Jamkly/planta-nivel-umsa/semestres/II 2023/3. Diseño de controladores/Caracterización de la planta/caracterizacion del sistema.docx

Universidad “Mayor de San Andrés”

FACULTAD DE INGENIERIA


CARACTERISTICAS DEL SISTEMA

Integrantes:

Univ. Espino Marca Mary Isabel

Univ. Condori Mamani Roger

Univ. Linares Poma Guido Alvaro

Univ. Huanaco Condori Heydi Marilyn

Univ. Quispe Lucana Williams

Univ. Ramos Queso Edith Elvira

Carrera: Ing. Electrónica

Materia: ETN-1034

Docente: Ing. Jorge Antonio Nava Amador

La Paz – Bolivia

# 1. MODELO ANALITICO

## 1.1 Linealizacion

Se tiene un tanque vertical abierto, provisto de un orificio o restriccion de descarga en su parte inferior, el tanque tiene un area A=l_1 xl_2 , tiene un caudal de entrada q_e por la parte superior , y un caudal q_s a la atmosfera por el orificio mencionado anteriormente.

donde:

A:area del tanque

q_e :caudal de entrada

q_s :caudal de salida

k:coeficiente de restriccion

h:altura del deposito


El caudal que fluye por una una restriccion sigue, basicamente, una ley cuadratica con la presion diferencial, pues se asume regimen turbulento.

En nuestro caso , un tanque abierto a la atmosfera, la presion diferencial en la restriccion de salida es debida a la presion hidrostatica existente como consecuencia del nivel de liquido en el tanque.

Si h es la altura del liquido, y k es un coeficiente dependiente de la geometria de la restriccion y de la densidad del liquido, el caudal de salida sera.

q_s =k√h (1)

Balance masico de caudales

entrada-salida=acumulacion

Por otra parte (dV)/(dt) es un caudal, y por otra parte dV=Adh , se tendria:

q_e -q_s =A(dh)/(dt) (2)

Es intuitivo el hecho de que, para un caudal de entrada constante, el nivel se estabilizara en un punto determinado, cuando la salida se iguale con la entrada, ya que a mayor nivel, mayor caudal de salida y viceversa.

Remplazando (2) en (1)

q_e -k√h=A(dh)/(dt) (3)

La ecuacion (3) es una funcion no lineal, entonces para linealizar se escoge un punto de equilibrio, es decir halla la altura de equilibrio h_0 , dado un determinado caudal de entrada q_e .

Entonces q_e =q_s y por tanto h=((q_s)/k)^2 . Pero el calculo se complica para condiciones transitorias , cuando q_s ≠q_e .

Es por ello, que en estos casos se procede linealizar la funcion de la ecuacion (3), mediante alguna forma de ecuacion aproximada, de tal manera que la ecuacion del caudal de salida q_s es sustituida por una ecuacion lineal.

Para ello se define una valor medio de h_m , preferentemente al nivel normal de trabajo, al que llamaremos nivel medio h_m y se opera con una funcion que corresponda a la ecuacion de una recta tangente a la funcion original en el punto [ h=h_m , q_s =q_m ].

Los valores medios, para el nivel medio normalmente el nivel de trabajo seran:

- Pendiente m de la recta tangente

m=(dq_s)/(dh)|_(h=h_m) =1/2k1/(√(h_m)) (4)

- Caudal medio de salida q_m :

q_m =k √(h_m) (5)

Por lo que:

k=(q_m)/(√(h_m)) (6) y, m=(q_m)/(2h_m) (7)

Efectuando un cambio de cordenadas a [ h_m , q_m ], en donde q y h representan los valores absolutos de las variables.


Con lo que la nueva ecuacion del balance masico queda:

q_e -mh=A(dh)/(dt) (8)

Reordenando y aplicando la transformada de laplace a la ecuacion (8)

Q_e =AsH+mH=H(As+m)

Entonces la función de transferencia será:

H/(Q_e)=1/(As+m)=(1/m)/((As)/m+1)=K/(Ts+1)

H/(Q_e)=K/(Ts+1) (9) funcion de transferencia linealizada


Donde:

q_m

h_m

K=1/m=Ganancia del sistema

T=A/m=Constante de tiempo

En el laboratorio se obtuvo las siguientes mediciones:

h_m =0.367m

q_m =0.28x10^(-3) (m^3)/s

Realizando calculos y remplazando en (9)

m=(q_m)/(2h_m)=(0.28x10^(-3))/(2⋅0.367)=0.381x10^(-3) (m^2)/s

H/(Q_e)=1/(As+m)=(1/m)/((As)/m+1)=2624.67/(419.95s+1)

H/(Q_e)=2624.67/(419.95s+1) funcion de transferencia analitica


Por otro lado realizando la linealizacion por series de taylor, tomando la siguiente ecuación no lineal:

A(dh)/(dT)=qe-k_2 a√(2gh)

Realizando la linealizacion se obtiene:

H/(Q_e)=1/(A S+(K_2 a √5)/(√(h_0)))

H/(Q_e)=1/(0.16 S+(0.02√5)/(√0.187))

H/(Q_e)=1/(0.16 S+(0.02√5)/(√0.187))

H/(Q_e)=1/(0.16 S+0.103)

Donde:

A=Area en m^2

h_0 =Altura donde el caudal de salida y entrada es igual,es decir no hay cambio en la altura

a=Areade la valvula de salida (del pequeño)

K_2 =Llave de paso que varia entre 0 y 1, tomando como 1 totalmente abierta

H=Altura de nivel

Q_e =Entrada de caudal


## 1.2 Modelo de la planta

Se tiene un tanque vertical abierto, provisto de un orificio o restricción de descarga en su parte inferior, el tanque tiene un área A=l_1 xl_2 , tiene un caudal de entrada q_e por la parte superior , y un caudal q_s a la atmosfera por el orificio mencionado anteriormente.


Donde:

A=l_1 xl_2 : área del tanque

q_e : caudal de entrada

q_s : caudal de salida

k: coeficiente de restricción

h: altura del deposito

- Ecuaciones fundamentales

q_e (t)=q_r (t)+q_c (t) (1)

h(t)=g(t)q_e (t) (2)

- Aplicando la transformada de Laplace

Q_e (s)=Q_r (s)+Q_c (s) (3)

H(s)=G(s)Q(s) (4)

- Caudal por la restricción

h(t)=q_r (t)k (5)

H(s)=Q_r (s)k (6)

- Caudal en la capacidad del tanque

h(t)=1/C∫ q_c (t)dt (7)

H(s)=1/(Cs)Q_c (s) (8)

- Reordenando y reemplazando la ecuación (6) y (8) en (3)

Q_e (s)=1/k·H(s)+Cs·H(s)

- Despejando obtenemos la función de transferencia

Q_e (s)=((1+kCs)/k)·H(s)

(H(s))/(Q_e (s))=k/(kCs+1)

Donde k es la ganancia del sistema y kC es

la contante de tiempo del sistema τ

En el laboratorio se obtuvo las siguientes medidas:

hm=0.367m

qm=0.28x10^(-3) (m^3)/s

C=A=0.16 m^2

Realizando cálculos y remplazando

k=h/q=0.367/(0.28x10^(-3))=1310.71 s/(m^2)

H/(Q_e)=k/(kCs+1)=1310.71/(209.71s+1)

(H(s))/(Q_e (s))=1310.71/(209.71s+1)

## 1.2 Respuesta temporal

F(s)=(Y(s))/(U(s))=(b0)/(s+a0)=K/(τs+1)

Donde: el sistema tiene un polo en: -a0

k: es la ganancia de estado estacionario, la cual entrega el valor que toma la respuesta del sistema para un tiempo que tiende a infinito.

k=(b0)/(a0)

La constante τ , es la constante de tiempo, la cual indicara el tiempo en el cual el sistema tiene un 63,21% del valor en estado estacionario.

τ=1/(a0)

Análisis de la respuesta a un escalón:

Si partimos de la suposición que nuestro sistema no posee retardo, nuestras funciones de transferencia de primer orden y ecuación temporales del sistema, estarían regidas por:

U(s)=A/s ; y(s)=K/(τs+1)*25/s=K*(a/(τs+1)+b/s)=K*(A/(τs+1)+b/s)

A=-τ ;B=1

y(s)=K*((-τ)/(τs+1)+1/s)=K*((-1)/(s+1/τ)+1/s)

y(t)=A*K*(1-e^((-t)/τ) );t≥0


De esa forma si sustituido de la ecuación temporal de primer orden anterior la variable de tiempo por diferentes valores, podremos obtener la respuesta dinámica característica del sistema de primer orden.

t | y(t)
0 | 0
τ | AK(1-e^(-1) )=0,632AK
2τ | AK(1-e^(-2) )=0,865AK
3τ | AK(1-e^(-3) )=0,95AK
4τ | AK(1-e^(-4) )=0,982AK
∞ | AK(1-e^(-∞) )=AK

## 1.4 Respuesta en frecuencia del sistema

La respuesta en frecuencia de un sistema de nivel de líquido indica cómo el sistema responde a diferentes frecuencias de entrada. Es una representación de la relación entre la amplitud y la fase de la señal de salida con respecto a la señal de entrada en función de la frecuencia.

Indica lo siguiente:

Ganancia en frecuencia: indica cómo el sistema responde a diferentes tasas de flujo de entrada o salida.

Frecuencia de corte: indicar la velocidad máxima a la que el sistema puede seguir cambios en el nivel de líquido. Si la frecuencia de corte es demasiado baja, el sistema puede no responder adecuadamente a fluctuaciones rápidas en el nivel de líquido

Retardo de fase: puede tener un impacto en la estabilidad y respuesta del sistema. Un retardo excesivo puede causar problemas de oscilación o inestabilidad en el control del nivel de líquido.


SISTEMA ESTABLE

Función de transferencia:
G(s)=0.09629/((152.5*s+1))

s=-1/(152,5)

Margen de ganancia:

0.09629/((152.5*s+1))=k

K=0.09629

En decibelios:

dB =20logk

dB =20log0.09629

dB=-20,32

margen de fase:

Gp=<0.09629/((152.5*s+1))

<0.09629/((152.5*jw+1))

θ_p =tan^(-1) (0/0.09629)-tan^(-1) ((152.5*w)/1)

θ_p =-5,71°

## 1.5 Estabilidad

se refiere a la capacidad del sistema para mantener el nivel de líquido dentro de límites deseados a lo largo del tiempo, sin presentar oscilaciones indeseadas ni divergencia hacia valores extremos.

El polo se encuentra en el lado izquierdo, próximo a el origen de coordenadas, lo que indica una respuesta lenta y se encuentra estable.

G(s)=0.09629/((152.5*s+1))

S=-0,006557


# 2. MODELO EMPIRICO

La FT experimental se obtuvo tomando datos de la altura h cada 20 (s) hasta que logre alcanzar su punto de equilibrio con un caudal de entrada

q_e =0.28 l/s

Puede revisar el punto 5.5 la guía de usuario (https://drive.google.com/file/d/1BsVT1bDOx7avse5KM7Aliyhdw-4IX3x0/view?usp=drive_link) para la obtención de datos

Análisis apoyado por computadora: Se refiere al uso de técnicas y herramientas computacionales para realizar un análisis, en este caso, de un sistema dinámico.

## 2.1 función de transferencia experimental

- Con la tabla de datos y con la función “ident” en Matlab, es posible obtener la función de transferencia:

El comando "ident" en MATLAB es una función utilizada para realizar la identificación de sistemas dinámicos a partir de datos experimentales. Permite estimar modelos matemáticos que describen el comportamiento de un sistema a partir de las respuestas obtenidas en pruebas o mediciones.

- Definiremos como entrada al caudal y como salida la altura.


Función de transferencia experimental

G_(`(`p)) =0.9585/(291.85*s+1)

- Aproximación de la función de transferencia del 84%: La función de transferencia es una representación matemática de la relación entrada-salida de un sistema dinámico. En este caso, se está aproximando esta función para capturar el 84% del comportamiento del sistema.
- Sistema de primer orden: Hace referencia a un tipo de sistema dinámico cuya función de transferencia tiene la forma característica de un sistema de primer orden.
- Sistema lento: Indica que el sistema en cuestión tiene una respuesta temporal más lenta en comparación con sistemas más rápidos. Esta información es relevante para elegir el modelo de aproximación adecuado.


Figure 1 respuesta al paso

# 3. ANALISIS

## 3.1Respuesta temporal del sistema

F(s)=(Y(s))/(U(s))=(b0)/(s+a0)=K/(τs+1)

Donde: el sistema tiene un polo en: -a0

k: es la ganancia de estado estacionario, la cual entrega el valor que toma la respuesta del sistema para un tiempo que tiende a infinito.

k=(b0)/(a0)

La constante τ , es la constante de tiempo, la cual indicara el tiempo en el cual el sistema tiene un 63,21% del valor en estado estacionario.

τ=1/(a0)

Análisis de la respuesta a un escalón:

t | y(t)
0 | 0
τ | AK(1-e^(-1) )=0,632AK
2τ | AK(1-e^(-2) )=0,865AK
3τ | AK(1-e^(-3) )=0,95AK
4τ | AK(1-e^(-4) )=0,982AK
∞ | AK(1-e^(-∞) )=AK

U(s)=A/s ; y(s)=K/(τs+1)*25/s=K*(a/(τs+1)+b/s)=K*(A/(τs+1)+b/s)

A=-τ ;B=1

y(s)=K*((-τ)/(τs+1)+1/s)=K*((-1)/(s+1/τ)+1/s)

y(t)=A*K*(1-e^((-t)/τ) );t≥0

De esa forma si sustituido de la ecuación temporal de primer orden anterior la variable de tiempo por diferentes valores, podremos obtener la respuesta dinámica característica del sistema de primer orden


El estado estacionario del sistema es cuando la dinámica deja de variar y alcanza un equilibrio. Este valor de equilibrio puede ser encontrado a través del teorema del valor final (https://controlautomaticoeducacion.com/analisis-de-sistemas/teorema-de-valor-final-y-inicial/).

### 3.1.1Teorema del valor final:

Cuando un sistema lineal llega a un estado estacionario, el sistema se estabiliza en un valor especifico.

y_(∞) =lims→0s*E(s)

y_(∞) = s*1/s*(0,09629)/(152,5s+1)

y_(∞) =0.09629*A


De la siguiente grafica se observa que el tiempo de establecimiento es bastante lento, tiene un tiempo de establecimiento de 19.75 [min].

## 3.2. respuesta en frecuencia del sistema experimental

Describe la respuesta en estado estacionario de un sistema a las entradas sinusoidales de frecuencias variables

Función de transferencia:


G_(`(`p)) =0.9585/(291.85*s+1)

s=-1/291

Margen de la ganancia: ‖Gp‖=k

0.09569/((291*s+1))=k

K=0.09569

dB=-20,3827

En decibelios:

dB =20logk

dB =20log0.09569

M argen de fase: <Gp=<0.09569/((303*s+1))

<0.09569/((291*jw+1))

θ_p =tan^(-1) (0/0.09569)-tan^(-1) ((303*w)/1)

θ_p =-45°

# 4. ESTABILIDAD

El sistema de control utilizado en el sistema de nivel de líquido es capaz de mantener el nivel de líquido dentro de límites deseados de manera precisa y estable. El control es capaz de ajustar la entrada o salida de líquido según sea necesario para mantener el nivel objetivo

## 4.1 Diagrama polar:

El polo se encuentra en el lado izquierdo, próximo a él origen de coordenadas, lo que indica una respuesta lenta y se encuentra estable.

El sistema de control utilizado en el sistema de nivel de líquido es capaz de mantener el nivel de líquido dentro de límites deseados de manera precisa y estable. El control es capaz de ajustar la entrada o salida de líquido según sea necesario para mantener el nivel objetivo


## 4.3 Criterio de estabilidad de Routh Hurwitz G_((s)) =0.9585/(291.85*s+1)

El polinomio característico se obtiene al igualar el denominador a cero: 291.85*s+1 =0

Entonces, el polinomio característico es simplemente: s+1/291.85=0

Para aplicar el criterio de Routh-Hurwitz, necesitamos escribir el polinomio característico en forma estándar. En este caso, la forma estándar es:

a_n s^n +a_(n-1) s^(n-1) +…+ a_1 s^1 + a_0 =0

Ahora, podemos construir la tabla de Routh-Hurwitz para este polinomio característico. La tabla tendrá dos filas: una para los coeficientes de s y otra para los coeficientes de s0 a_n =1 n=1

Para determinar la estabilidad, necesitamos asegurarnos de que todos los coeficientes en la fila de s1 sean positivos. En este caso, el coeficiente es 11, que es positivo. Por lo tanto, el sistema es estable de acuerdo con el criterio de Routh-Hurwitz.

s^1 | 1
s^1 | 1/291.85

# 5. MODELO EN ESPACIO DE ESTADOS

Las matrices de espacio de estados correspondientes son:

x=Ax+Bu

y=Cx+Du

Estas matrices representan el sistema en el espacio de estados. La ecuación de espacio de estados correspondiente es:

A=[-1/T]=[-1/291.85]

B=[K/T]=[0.9585/291.85]

C=[1]

D=[0]

Donde x es el vector de estado, u es el vector de entrada, y y es el vector de salida del sistema.

x=+[-1/291.85]x+[0.9585/291.85]u

y=[1]x

x=[-0.00342]x+[0.00328]u

y=[1]x

# 6. CONTROLABILIDAD Y OBSERVEBILIDAD

De las siguiente matriz de espacio de estados

x=[-0.00342]x+[0.00328]u

y=[1]x

## 6.1 Controlabilidad:

- La controlabilidad es la propiedad que indica si el comportamiento de un sistema puede ser controlado por sus entradas.
- Se dice que un sistema es completamente controlable si puede pasar de cualquier estado inicial a cualquier estado final en un tiempo finito usando una entrada de control.
- La controlabilidad depende de la arquitectura interna del sistema y los valores de sus componentes.

El sistema es controlable si y solo si la matriz de controlabilidad (Wc) tiene rango completo. En este caso, la matriz Wc linealmente independientes, lo que significa que el sistema es controlable.

W_c =[B ]

AB=[0.00328]

W_c =[0.00328 ]

Wc≠0

## 6.2 Observabilidad:

- La observabilidad es la propiedad que indica si el comportamiento de un sistema se puede observar a partir de sus salidas.
- Se dice que un sistema es completamente observable si sus estados internos pueden determinarse a partir de sus salidas.
- La observabilidad depende de la arquitectura interna del sistema y los valores de sus componentes.

Observabilidad: El sistema es observable si y solo si la matriz de observabilidad (Wo) tiene rango completo. En este caso, la matriz Wo linealmente independientes, lo que significa que el sistema es observable.

W_o =[C]

W_o =[1]

Wo≠0

# 7. CRITERIO DE ESTABILIDAD DE LYPUNOV

Teorema 1: es estable si y solo si todos los autovalores de A tienen parte real no positiva y aquellos con parte real cero estan asociados a un bloque de jordan de orden 1

x=[-0.00342]x+[0.00328]u

y=[1]x

det⁡(A-λI)=0

El autovalor de esta matriz es simplemente el único elemento en la matriz, a.

A=[-0.00342]

Como es real negativo es estable

# 8. CONCLUSIONES

- Se pudo obtener la función de transferencia experimental y teórica, dándonos la misma altura de referencia.
- Pero se pudo evidenciar que hay una diferencia en el tiempo de subida en ambas funciones, esto es debido a que no estamos considerando las turbulencias que se presentan al momento de cargar el líquido en el tanque.
- La respuesta temporal de la planta teórica es equivalente a la respuesta experimental obtenida, sin embargo, la influencia de las perturbaciones modifica la respuesta transitoria.
- El sistema nivel de líquido presenta una respuesta temporal lenta, para lo cual fueron necesarios muestras relativamente grandes T= 20[s], pero para mayor precisión se tomaron varias mediciones para cada T= 10[s], para su obtención.
