Jamkly/planta-nivel-umsa/semestres/II 2023/3. Diseño de controladores/Diseño del controlador/control clasico pid.docx

Universidad “Mayor de San Andrés”

FACULTAD DE INGENIERIA


CONTROLADOR CLASICO PID

Integrantes:

Univ. Linares Poma Guido Alvaro

Univ. Huanaco Condori Heydi Marilyn

Univ. Quispe Lucana Williams

Univ. Ramos Queso Edith Elvira

Carrera: Ing. Electrónica

Materia: ETN-1034

Docente: Ing. Jorge Antonio Nava Amador

La Paz – Bolivia

# 1. OBJETIVO

El objetivo al diseñar el controlador Truxal se basa en cumplir con tres condiciones fundamentales: realización física, estabilidad interna y error en régimen permanente nulo.

# 2. CONDICIONES

## 2.1. Condición de Realización Física (continua):

- El controlador C(s) se define como C(s)=Dc(s)Nc(s).
- Se debe cumplir que el grado de Dc(s) sea mayor o igual al grado de Nc(s) para garantizar que el sistema sea causal.

## 2.2. Condición de Estabilidad Interna (continua):

- No debe haber cancelación de polos inestables entre C(s) y G(s) (función de transferencia del sistema en bucle abierto).
- Si G(s) tiene un polo inestable en s=α, se asegura que α sea un cero de la función de transferencia en bucle cerrado 1+C(s)G(s).

## 2.3. Condición de Error en Régimen Permanente Nulo (continua):

- El controlador debe garantizar que el sistema tenga un error nulo en régimen permanente.
- Se define el error en bucle cerrado E(s) y el error en régimen permanente erp.
- Para una entrada tipo escalón, se asegura que lims→0s(1+C(s)G(s))=0.

# 3. DISEÑO

Función de transferencia a lazo abierto

G_(`(`p)) =0.9585/(291.85*s+1)

Tiempo de asentamiento

ts =1141.5 seg = 19.025 min


Función de transferencia Objetivo

G_(`(`p)) =1/(150*s+1)


Tiempo de asentamiento

ts =4*ꚍd = 600seg = 10 min

Función del controlador

Remplazando una ecuación en otra:

G_((c)) =(291.85s+1)/(143.78s)

Despejando los términos para su modelo en pid

G_(`(`p)) =2.0298+0.0069551/s

Si consideramos que pose 10 muestras por constante de tiempo

Periodo de muestreo máximo para que la señal no quede desvirtuada

Periodo mínimo que podemos tomar en base al modulo de expansión

# 4. SIMULACIÓN

- El sistema de nivel de liquido cuenta con un motor que tiene como máxima frecuencia de funcionamiento 40Hz, debido a esto tenemos una saturación del actuador por lo que nuestro tiempo de establecimiento no puede ser muy pequeño como se podría ser en una simulación
- Por defecto ya que nuestro sistema es de primer orden y no tiene sobre pico nuestro controlador no modificara este comportamiento debido a que no estamos reduciendo mucho el tiempo de establecimiento.

Se llevó a cabo la simulación utilizando la herramienta Simulink de Matlab, durante la cual se incorporó la funcionalidad de saturación al controlador.


Saturación a 40hz

Salida sin saturación

Salida con saturación


# 5. IMPLEMENTACION

Para realizar la implementación has revisar el punto de puesta en marcha de guía de usuario (https://drive.google.com/file/d/1BsVT1bDOx7avse5KM7Aliyhdw-4IX3x0/view?usp=drive_link)
