Jamkly/planta-nivel-umsa/semestres/II 2023/8. Presentaciones/Caracterización SN 2-2023.pptx

## Sistema de nivel de liquido

Asignatura: ETN - 1034
Integrantes: Linares Poma Guido Alvaro
Huanaco Condori Heydi Marilyn
Quispe Lucana Williams
Ramos Queso Edith
Semestre : ll - 2023


## MODELAR


## Obtención de la función de transferencia

- Ecuaciones fundamentales
q_e (t)=q_r (t)+q_c (t) (1)
h(t)=g(t)q_e (t) (2)
- Aplicando la transformada de Laplace
Q_e (s)=Q_r (s)+Q_c (s) (3)
H(s)=G(s)Q_e (s) (4)
- Caudal por la restricción
h(t)=q_r (t)k (5)
H(s)=Q_r (s)k (6)
- Caudal en la capacidad del tanque
h(t)=1/C∫ q_c (t)dt (7)
H(s)=1/(Cs)Q_c (s) (8)

- kC(dh(t))/(dt)+h(t)=kQ_e (s)
- Reordenando y reemplazando la ecuación (6) y (8) en (3)
Q_e (s)=1/k·H(s)+Cs·H(s)
- Despejando obtenemos la función de transferencia
Q_e (s)=((1+kCs)/k)·H(s)
(H(s))/(Q_e (s))=k/(kCs+1)
Donde k es la ganancia del sistema y kC es
la contante de tiempo del sistema τ

## Slide 4

En el laboratorio se obtuvo las siguientes medidas:
hm=0.367m
qm=0.28x10^(−3) (m^3)/s
C=A=0.16 m^2
Realizando cálculos y remplazando
k=h/q=0.367/(0.28x10^(−3))=1310.71 s/(m^2)
H/(Q_e)=k/(kCs+1)=1310.71/(209.71s+1)
(H(s))/(Q_e (s))=1310.71/(209.71s+1)

Función de transferencia analítica


h_m

q_m

Vista frontal del tanque superior

## Diagrama de bloques

ref

h

## Slide 6

Elementos a utilizar para el control de nivel

Ver las imágenes de origen
Electrobomba Centrifuga CM 100 1HP Marca Pentax

## Slide 7


## Slide 8

ANALIZAR

Respuesta al paso: para ver el comportamiento


Información sobre la respuesta al paso:
Tiempo de subida: 641.0573 segundos
Tiempo de asentamiento: 1141.0743 segundos
Overshoot: 0 %
Pico: 0.95853

## Slide 9

ANALIZAR

Respuesta al impulso: respuesta a una perturbación

## Slide 10

Estabilidad del sistema

Diagrama polar: ver la localización de sus polos y ceros


## Slide 11

Estabilidad del sistema

Diagrama de bode


## Criterio de estabilidad de routh

G_((s)) =0.9585/(291.85∗s+1)
291.85∗s+1 =0
s+1/291.85=0
a_n s^n +a_(n−1) s^(n−1) +…+ a_1 s^1 + a_0 =0
a_n =1 n=1

- El polinomio característico se obtiene al igualar el denominador a cero:
- Entonces, el polinomio característico es simplemente:
- Para aplicar el criterio de Routh-Hurwitz, necesitamos escribir el polinomio característico en forma estándar. En este caso, la forma estándar es:
- Ahora, podemos construir la tabla de Routh-Hurwitz para este polinomio característico. La tabla tendrá dos filas: una para los coeficientes de s y otra para los coeficientes de s0
- Para determinar la estabilidad, necesitamos asegurarnos de que todos los coeficientes en la fila de s1 sean positivos. En este caso, el coeficiente es 11, que es positivo. Por lo tanto, el sistema es estable de acuerdo con el criterio de Routh-Hurwitz.

s^1 | 1
s^1 | 1/291.85

## Espacio de estados

x=Ax+Bu
y=Cx+Du
A=[−1/T]=[−1/291.85]
B=[K/T]=[0.9585/291.85]
C=[1]
D=[0]
x=+[−1/291.85]x+[0.9585/291.85]u
y=[1]x
x=[−0.00342]x+[0.00328]u
y=[1]x

- Las matrices de espacio de estados correspondientes son:
- Estas matrices representan el sistema en el espacio de estados. La ecuación de espacio de estados correspondiente es:
- Donde x es el vector de estado, u es el vector de entrada, y y es el vector de salida del sistema.

## Controlabilidad y observebilidad

- De las siguiente matriz de espacio de estados
- Controlabilidad: El sistema es controlable si y solo si la matriz de controlabilidad (Wc) tiene rango completo. En este caso, la matriz Wc linealmente independientes, lo que significa que el sistema es controlable.
- Observabilidad: El sistema es observable si y solo si la matriz de observabilidad (Wo) tiene rango completo. En este caso, la matriz Wo linealmente independientes, lo que significa que el sistema es observable.

x=[−0.00342]x+[0.00328]u
y=[1]x
W_c =[B ]
AB=[0.00328]
W_c =[0.00328 ]
Wc≠0
W_o =[C]
W_o =[1]
Wo≠0

## CRITERIO DE ESTABILIDAD DE LYPUNOV

- Teorema 1: es estable si y solo si todos los autovalores de A tienen parte real no positiva y aquellos con parte real cero estan asociados a un bloque de jordan de orden 1
- Autovalor
- El autovalor de esta matriz es simplemente el único elemento en la matriz, a.

x=[−0.00342]x+[0.00328]u
y=[1]x
det⁡(A−λI)=0
A=[−0.00342]
Como es real negativo es estable

## Diseño de controlador

(Método truxal)

Función de transferencia a lazo abierto

Función de transferencia Objetivo

G_(`(`p)) =1/(150∗s+1)

G_(`(`p)) =0.9585/(291.85∗s+1)


Tiempo de asentamiento
ts =1141.5 seg = 19.025 min


G_((c)) =(291.85s+1)/(143.78s)

G_(`(`p)) =2.0298+0.0069551/s

Tiempo de asentamiento
ts =4*ꚍd = 600seg = 10 min

## Slide 17

CRITERIOS DE DISEÑO:

- El sistema de nivel de liquido cuenta con un motor que tiene como máxima frecuencia de funcionamiento 40Hz, debido a esto tenemos una saturación del actuador por lo que nuestro tiempo de establecimiento no puede ser muy pequeño como se podría ser en una simulación
- Por defecto ya que nuestro sistema es de primer orden y no tiene sobre pico nuestro controlador no modificara este comportamiento debido a que no estamos reduciendo mucho el tiempo de establecimiento.

1. Tiempo de Establecimiento (Ts): 10 min
2. Máximo Sobre pico (Mp): 0
3. Error en régimen Estacionario:. NULO
4. Estabilidad: SI
5. Rechazo de Perturbaciones: SI

## controlador


Salida con saturación

Salida sin saturación


Saturación a 40hz
