Jamkly/planta-nivel-umsa/semestres/II 2023/Trabajo realizado 2-2023  Sistema de Nivel.pdf

## Trabajo Realizado 2-2023 ETN 1034

Driver: SISTEMA DE NIVEL DE LIQUIDO ETN-1034 (II 2023) (https://drive.google.com/drive/folders/1CajYXwuBVz07tyqC0RaYFu18zBC4-MiU)

Documentación y Videos

Integrantes:
Univ. Linares Poma Guido Alvaro Univ. Huanaco Condori Heydi Marilyn Univ. Quispe Lucana Williams
Univ. Ramos Queso Edith Elvira

### 1. NORMAS

a. Normas específicas y accesorias de IBNORCA
b. Norma ISA S5.1 84(R1992) Identificación y símbolos de instrumentación
c. Norma ISA S5.3-1983 símbolos gráficos para control distribuido, sistemas lógicos y computarizados.
d. Norma ISA S5.5 (1885) símbolos gráficos para identificación de procesos
2. Modelado del sistema en AUTOCAD 3D drive:

### 3. Diagrama electrico del sistema con AUTOCAD ELECTRICAL

https://drive.google.com/drive/folders/14h2U-rV61owXZ0V3LjImMDP4xmu33V0X

### 4. Caracterización de la planta

a. Nueva función de transferencia experimental
b. Adquisición de datos desde el PLC
c. Calibración del sensor ultrasónico
d. Calibración del factor K del Dosificador

### 5. Diseño del controlador PI 6. Mantenimiento correctivo y preventivo

a. Pintado del tanque superior (metálico)
b. Limpieza del tanque inferior

### 7. Configuración del adaptador de red para la máquina virtual 8. Modificación de las bitácoras de anteriores semestres 9. Videos complementarios a los videos del semestre ll-2022

a. Adquisición de datos
b. Carga del programa del controlador
c. Funcionamiento del emulador
d. Puesta en marcha modo básico
e. Puesta en marcha modo modificado
f. Reconocimiento del sistema
g. Video configuración del adaptador de red

### 10. Realización de la guía rápida del sistema de nivel de líquido 11. Organización y selección de la documentación referente al Sistema de Nivel
