Jamkly/planta-nivel-umsa/semestres/II 2023/1. Representación/Diagramas/Imagenes PNG/V FRONTAL.png

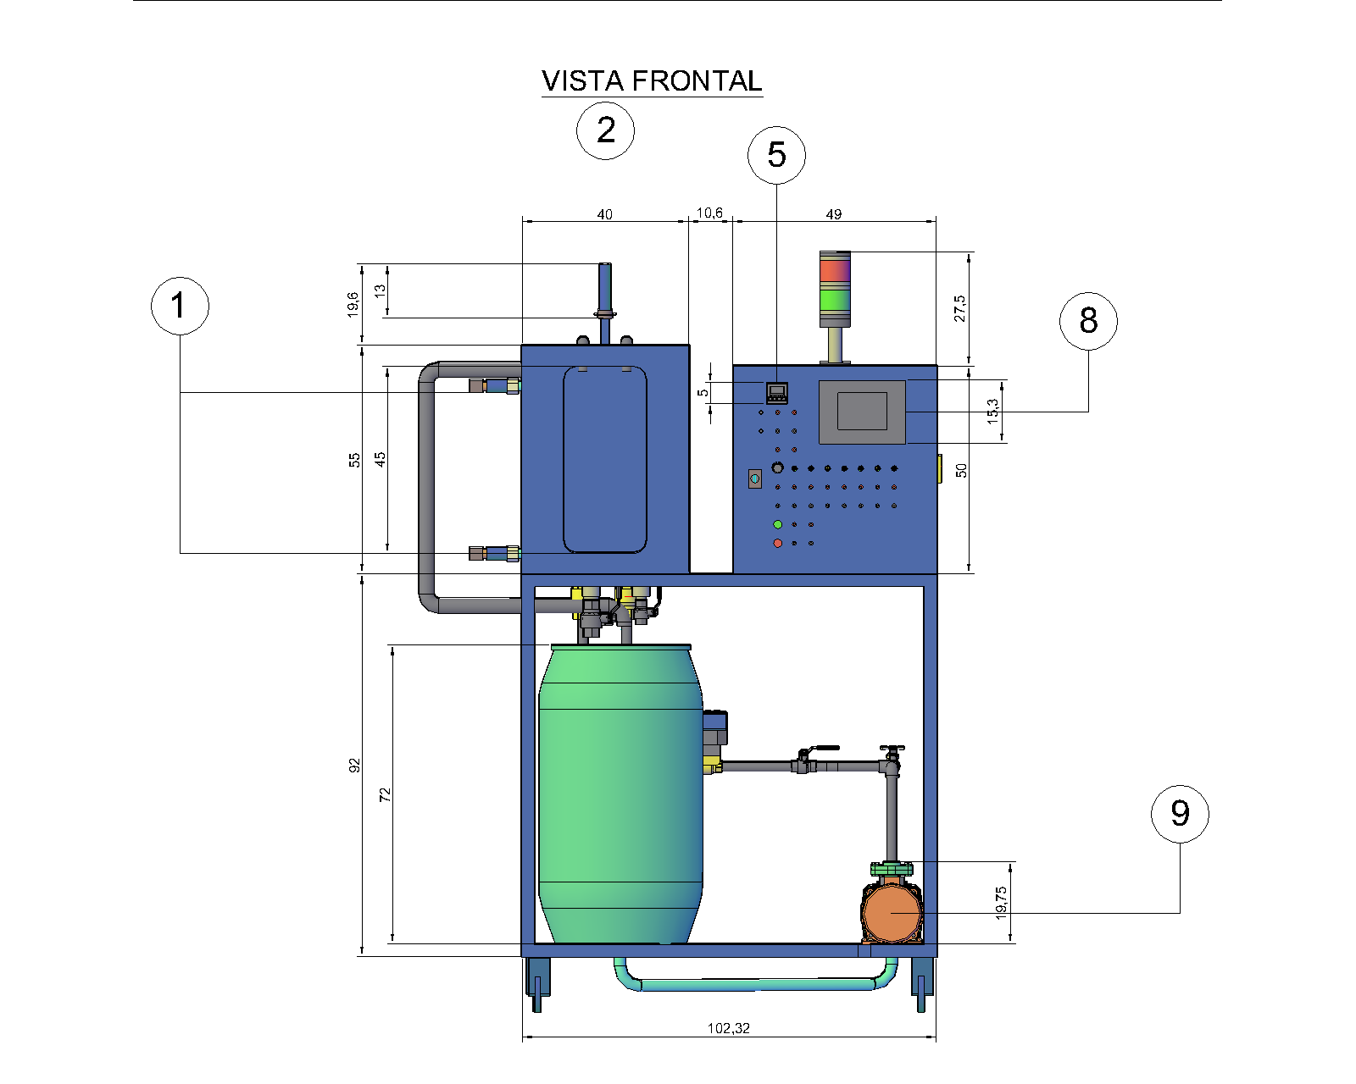
semestres/II 2023/1. Representación/Diagramas/Imagenes PNG/V FRONTAL.png
