Jamkly/planta-nivel-umsa/semestres/II 2023/1. Representación/Diagramas/Imagenes PNG/V POSTERIOR.png

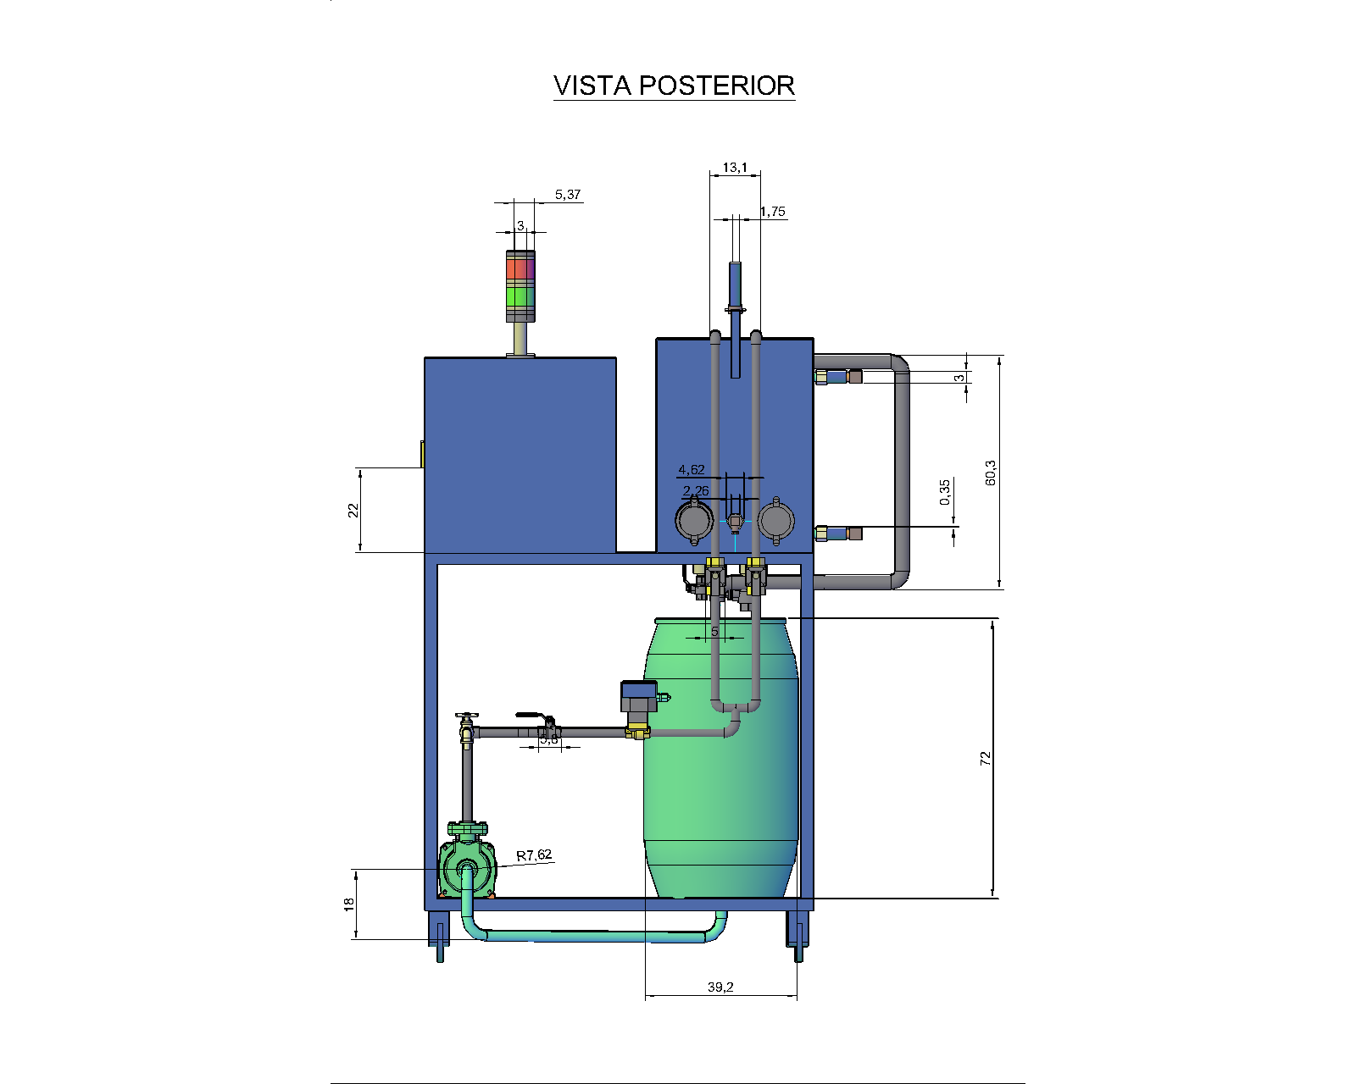
semestres/II 2023/1. Representación/Diagramas/Imagenes PNG/V POSTERIOR.png
