Jamkly/planta-nivel-umsa/semestres/II 2023/1. Representación/Diagramas/Imagenes PNG/VISTA LATERAL IZQUIERDA.png

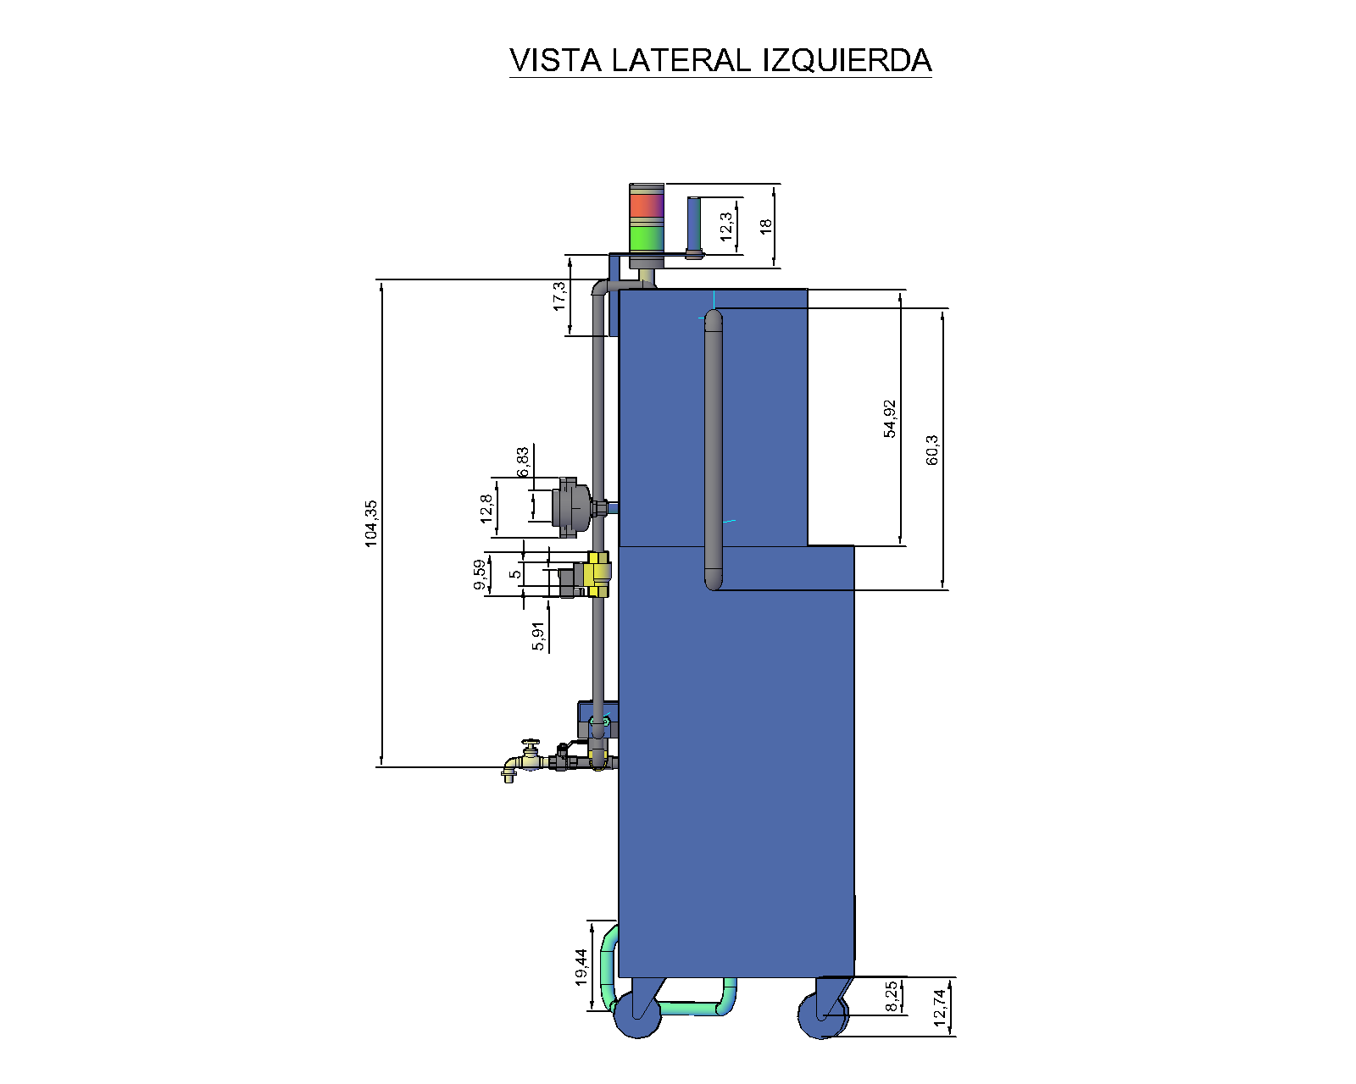
semestres/II 2023/1. Representación/Diagramas/Imagenes PNG/VISTA LATERAL IZQUIERDA.png
