Jamkly/planta-nivel-umsa/(list of files, cad)

Other CAD files:
semestres/II 2023/1. Representación/Diagramas/Diagrama eléctrico y P&ID.dwg
semestres/II 2023/1. Representación/Modelos 3D/Sistema de Nivel 3D.dwg
semestres/II 2023/otros previos/tanque3d2.dwg
semestres/II 2023/1. Representación/Diagramas/SISTEMA DE NIVEL - vistas ortogonales 2.dwg
semestres/II 2023/1. Representación/Modelos 3D/SISTEMA DE NIVEL - 2D.dwg
semestres/II 2023/1. Representación/Diagramas/SISTEMA DE NIVEL - vistas ortogonales 1.dwg
