Jamkly/planta-nivel-umsa/semestres/II 2023/1. Representación/Diagramas/Documentos PDF/SISTEMA DE NIVEL - VISTAS ORTOGONALES.pdf

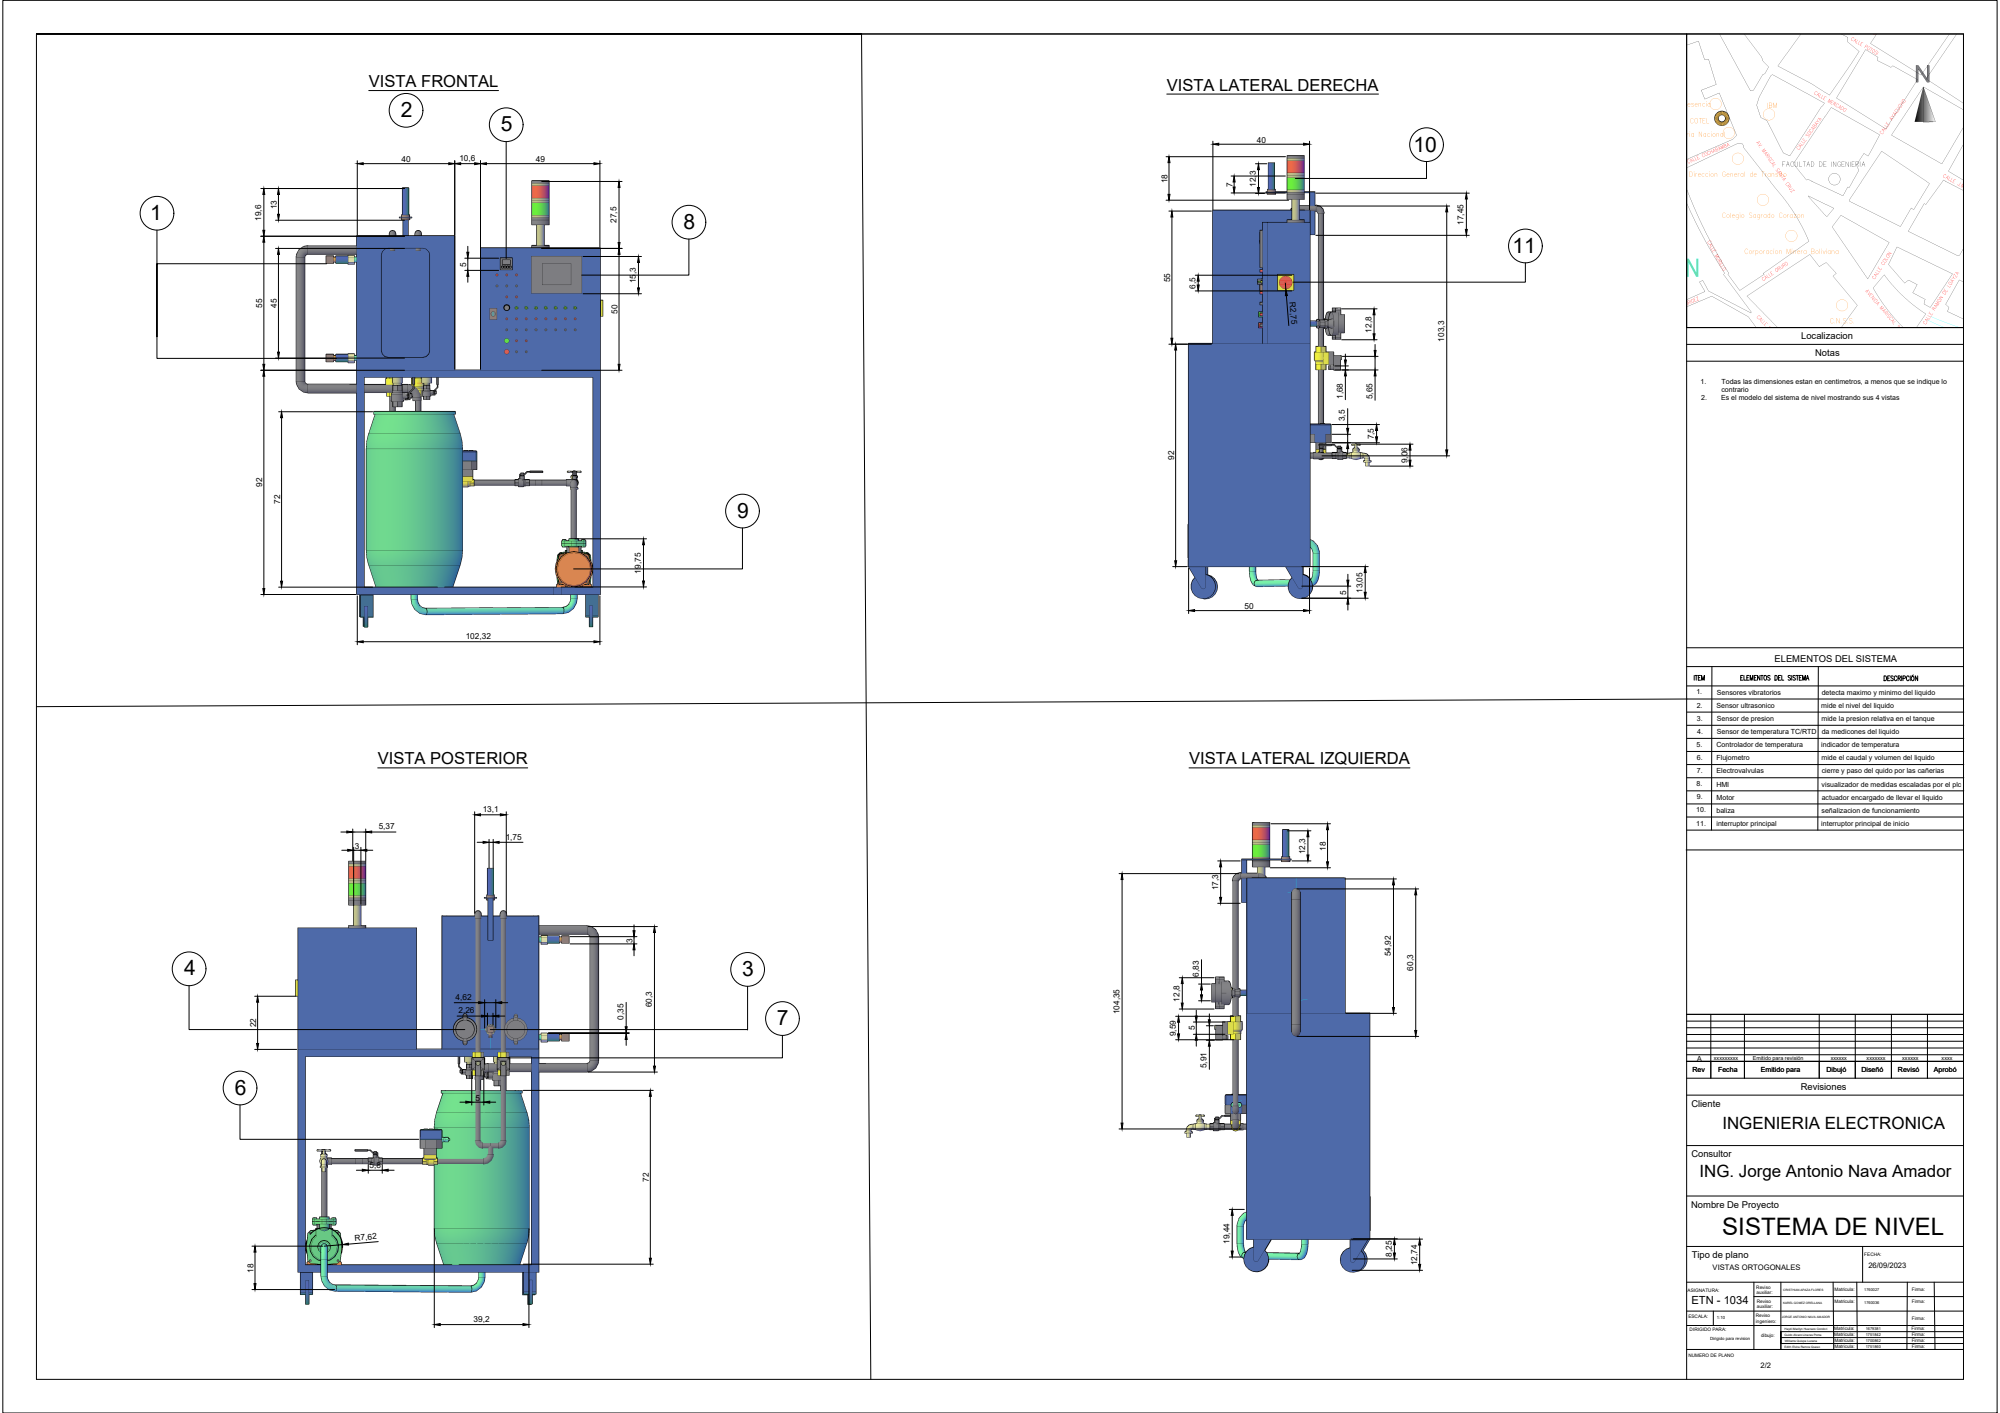
[picture p339: page 1]
Rev; Fecha; Emitido para; Dibujó; Diseñó; Revisó; Aprobó; Aprobó A; xxxxxxxxx; Emitido para revisión; xxxxxx; xxxxxxx; xxxx; INGENIERIA ELECTRONICA; VISTA FRONTAL; VISTA LATERAL DERECHA; VISTA POSTERIOR; VISTA LATERAL IZQUIERDA; Sensores vibratorios; detecta maximo y minimo del liquido; Sensor ultrasonico; mide el nivel del liquido; Guido Alvaro Linares Poma; 1751842 Williams Quispe Lucana; Edith Elvira Ramos Queso; 1751860 Matricula:; Firma: Matricula:; Firma: 3 1

Todas las dimensiones estan en centimetros, a menos que se indique lo
contrario
Es el modelo del sistema de nivel mostrando sus 4 vistas

ELEMENTOS DEL SISTEMA

3. | Sensor de presion | mide la presion relativa en el tanque

4. | Sensor de temperatura TC/RTD | da medicones del liquido

5. | Controlador de temperatura | indicador de temperatura

6. | Flujometro | mide el caudal y volumen del liquido

7. | Electrovalvulas | cierre y paso del quido por las cañerias

8. | HMI | visualizador de medidas escaladas por el plc

9. | Motor | actuador encargado de llevar el liquido

10. | baliza | señalizacion de funcionamiento

11. | interruptor principal | interruptor principal de inicio

Consultor
ING. Jorge Antonio Nava Amador

Nombre De Proyecto
SISTEMA DE NIVEL

Tipo de plano VISTAS ORTOGONALES | FECHA: 26/09/2023

ASIGNATURA: ETN - 1034 | Reviso auxiliar: | CRISTHIAN APAZA FLORES | Matricula:

Reviso auxiliar: | KAREL GOMEZ ORELLANA | | 1760036 | Firma: Firma: Firma:

ESCALA: DIRIGIDO PARA: | 1:10 | Reviso ingeniero: | JORGE ANTONIO NAVA AMADOR

Dirigido para revision | | dibujo: | Heydi Marilyn Huanaco Condori | Matricula: | 1679381 | Firma:

NUMERO DE PLANO
