Jamkly/planta-nivel-umsa/semestres/II 2023/1. Representación/Diagramas/Documentos PDF/SISTEMA DE NIVEL - 1 SIMBOLOS P&ID.pdf

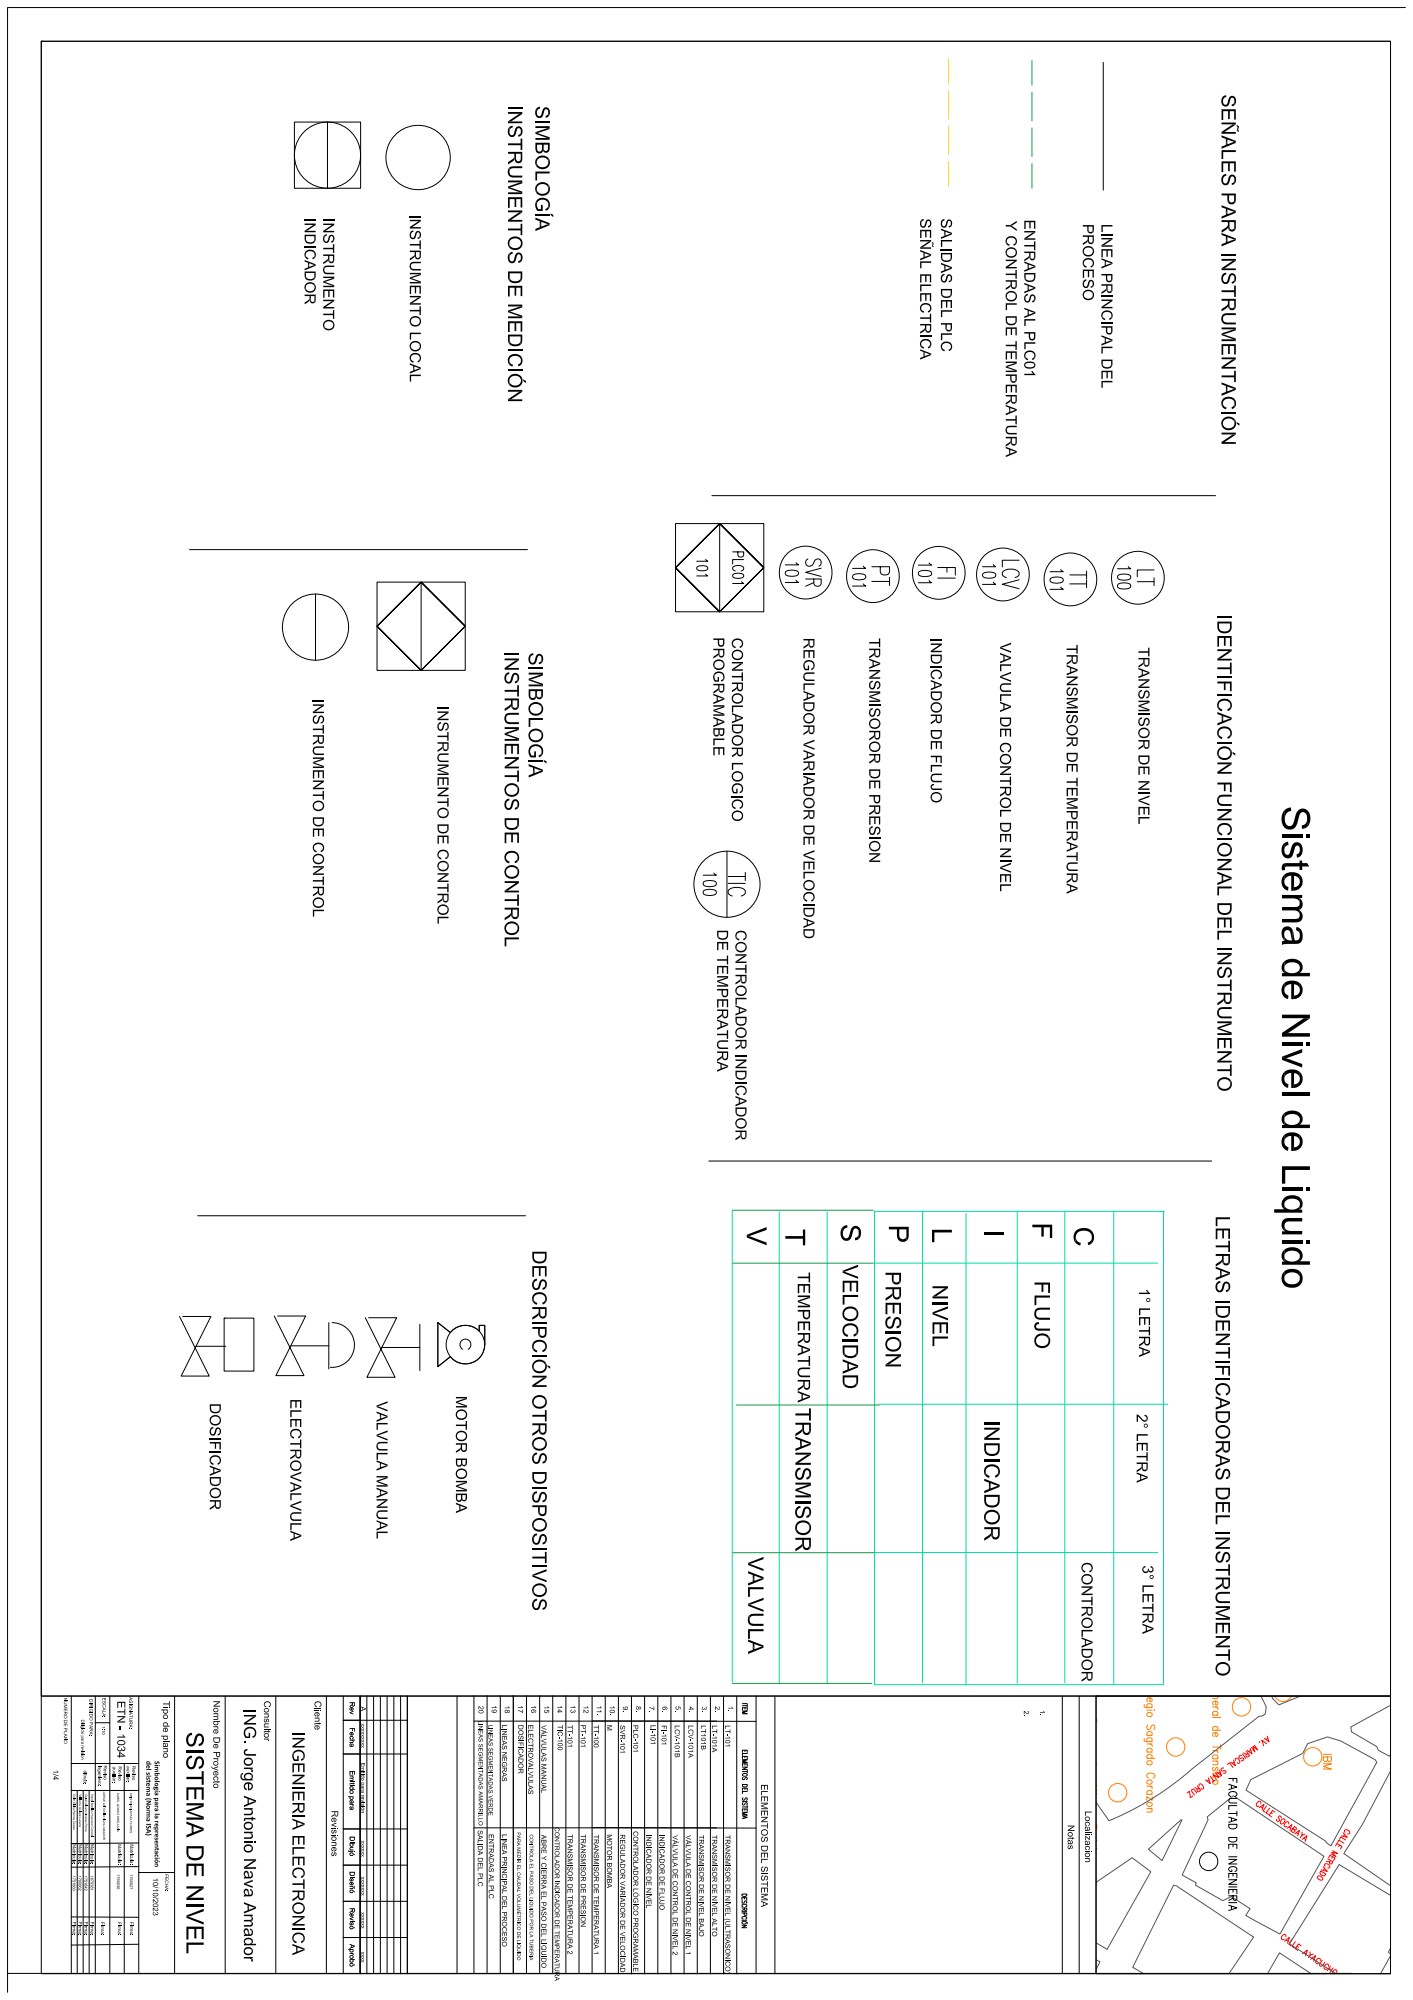
[picture p340: page 1]
