Jamkly/planta-nivel-umsa/semestres/II 2023/1. Representación/Diagramas/Documentos PDF/SISTEMA DE NIVEL - 2 P&ID.pdf

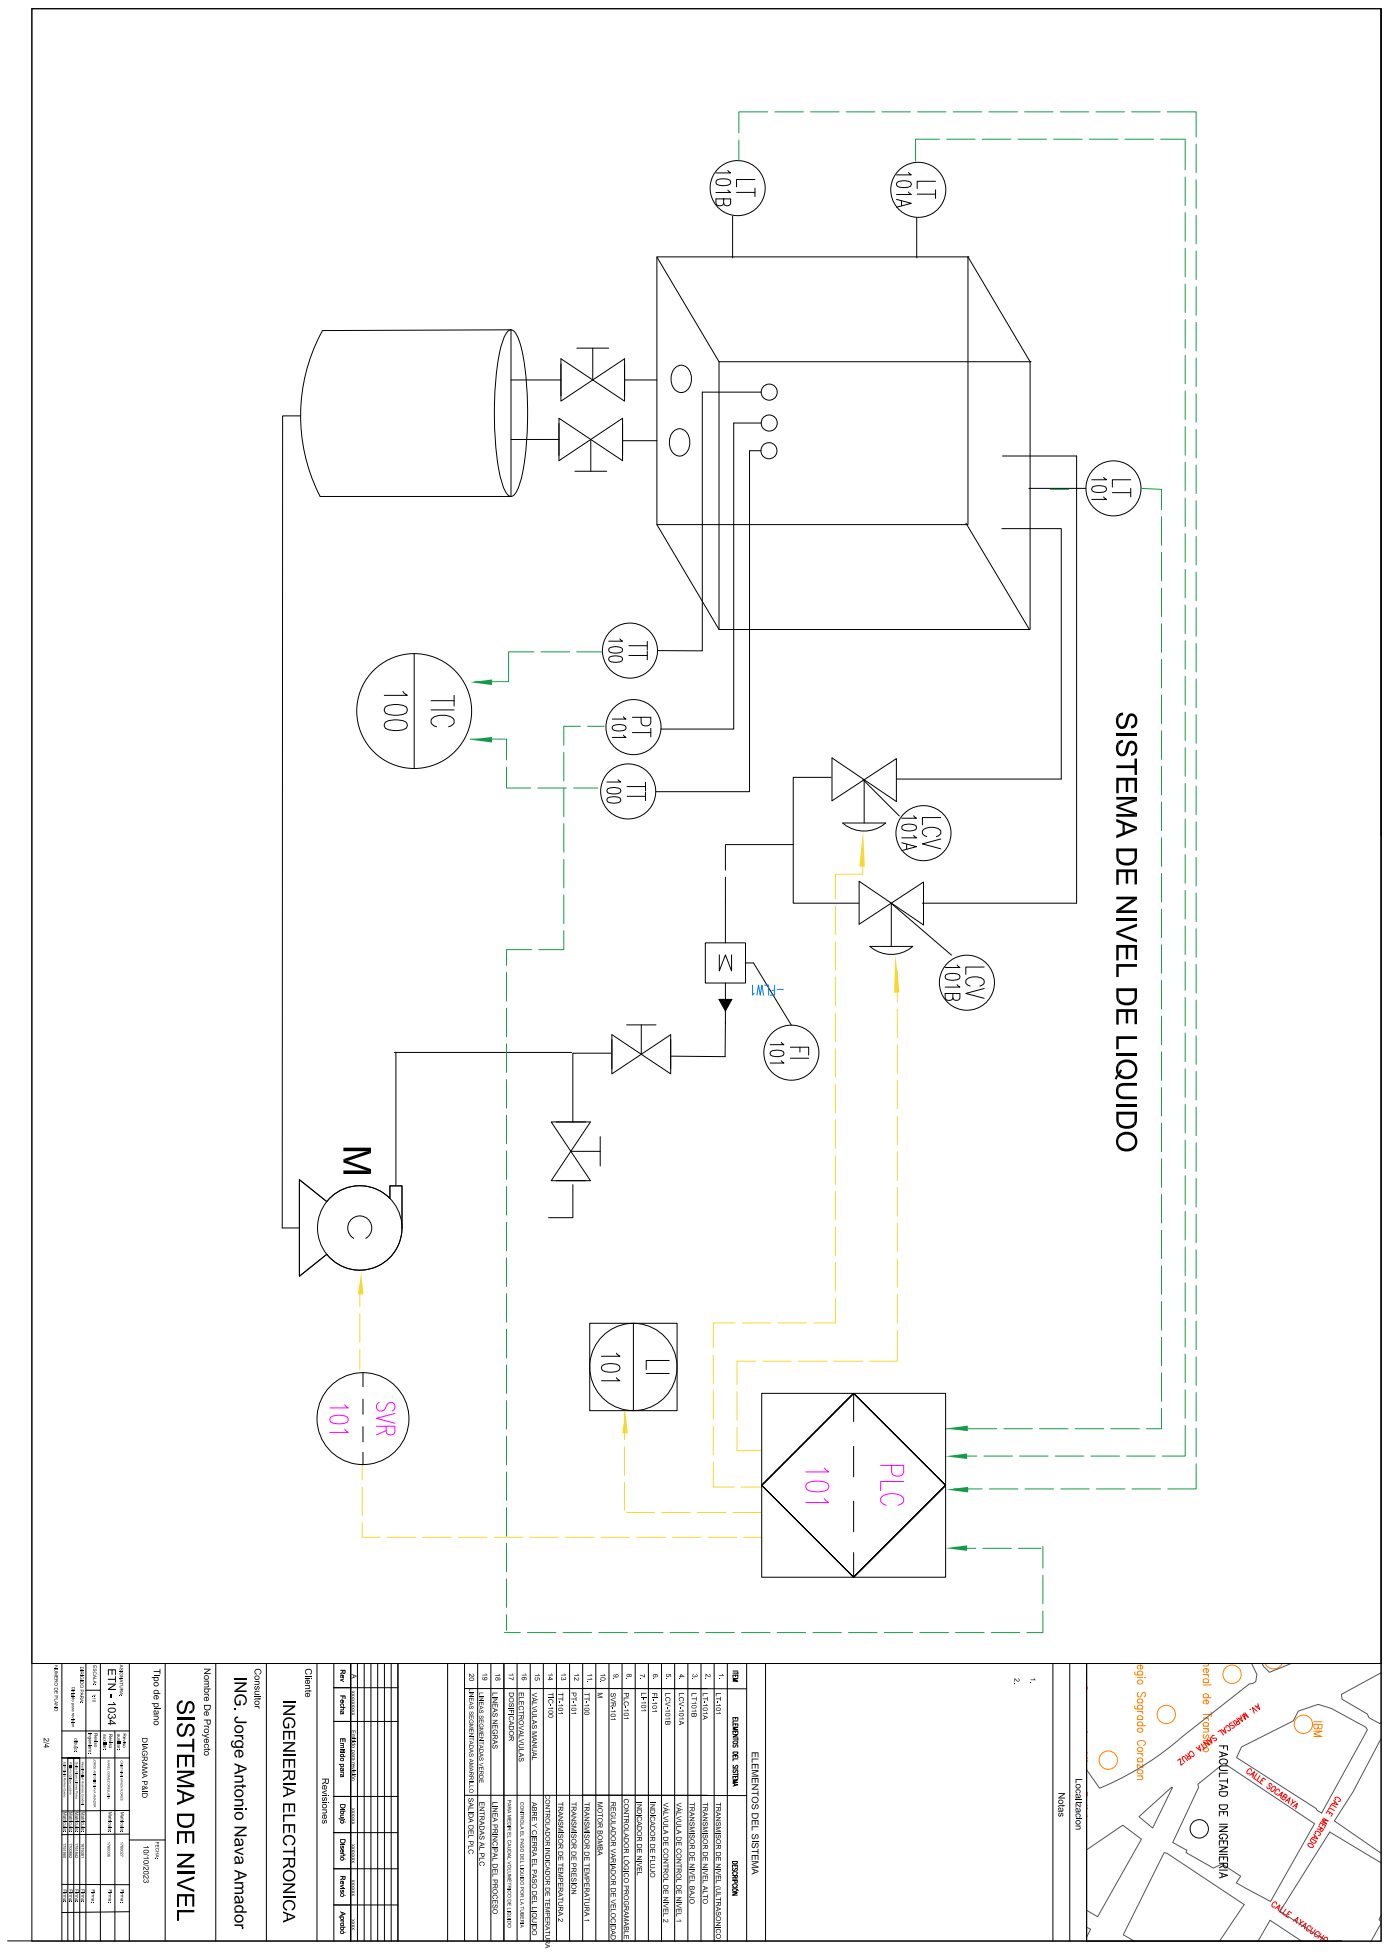
[picture p341: page 1]
