Jamkly/planta-nivel-umsa/semestres/II 2023/1. Representación/Diagramas/Documentos PDF/SISTEMA DE NIVEL - 3 DIAGRAMA ELECTRICO DEL PANEL 1.pdf

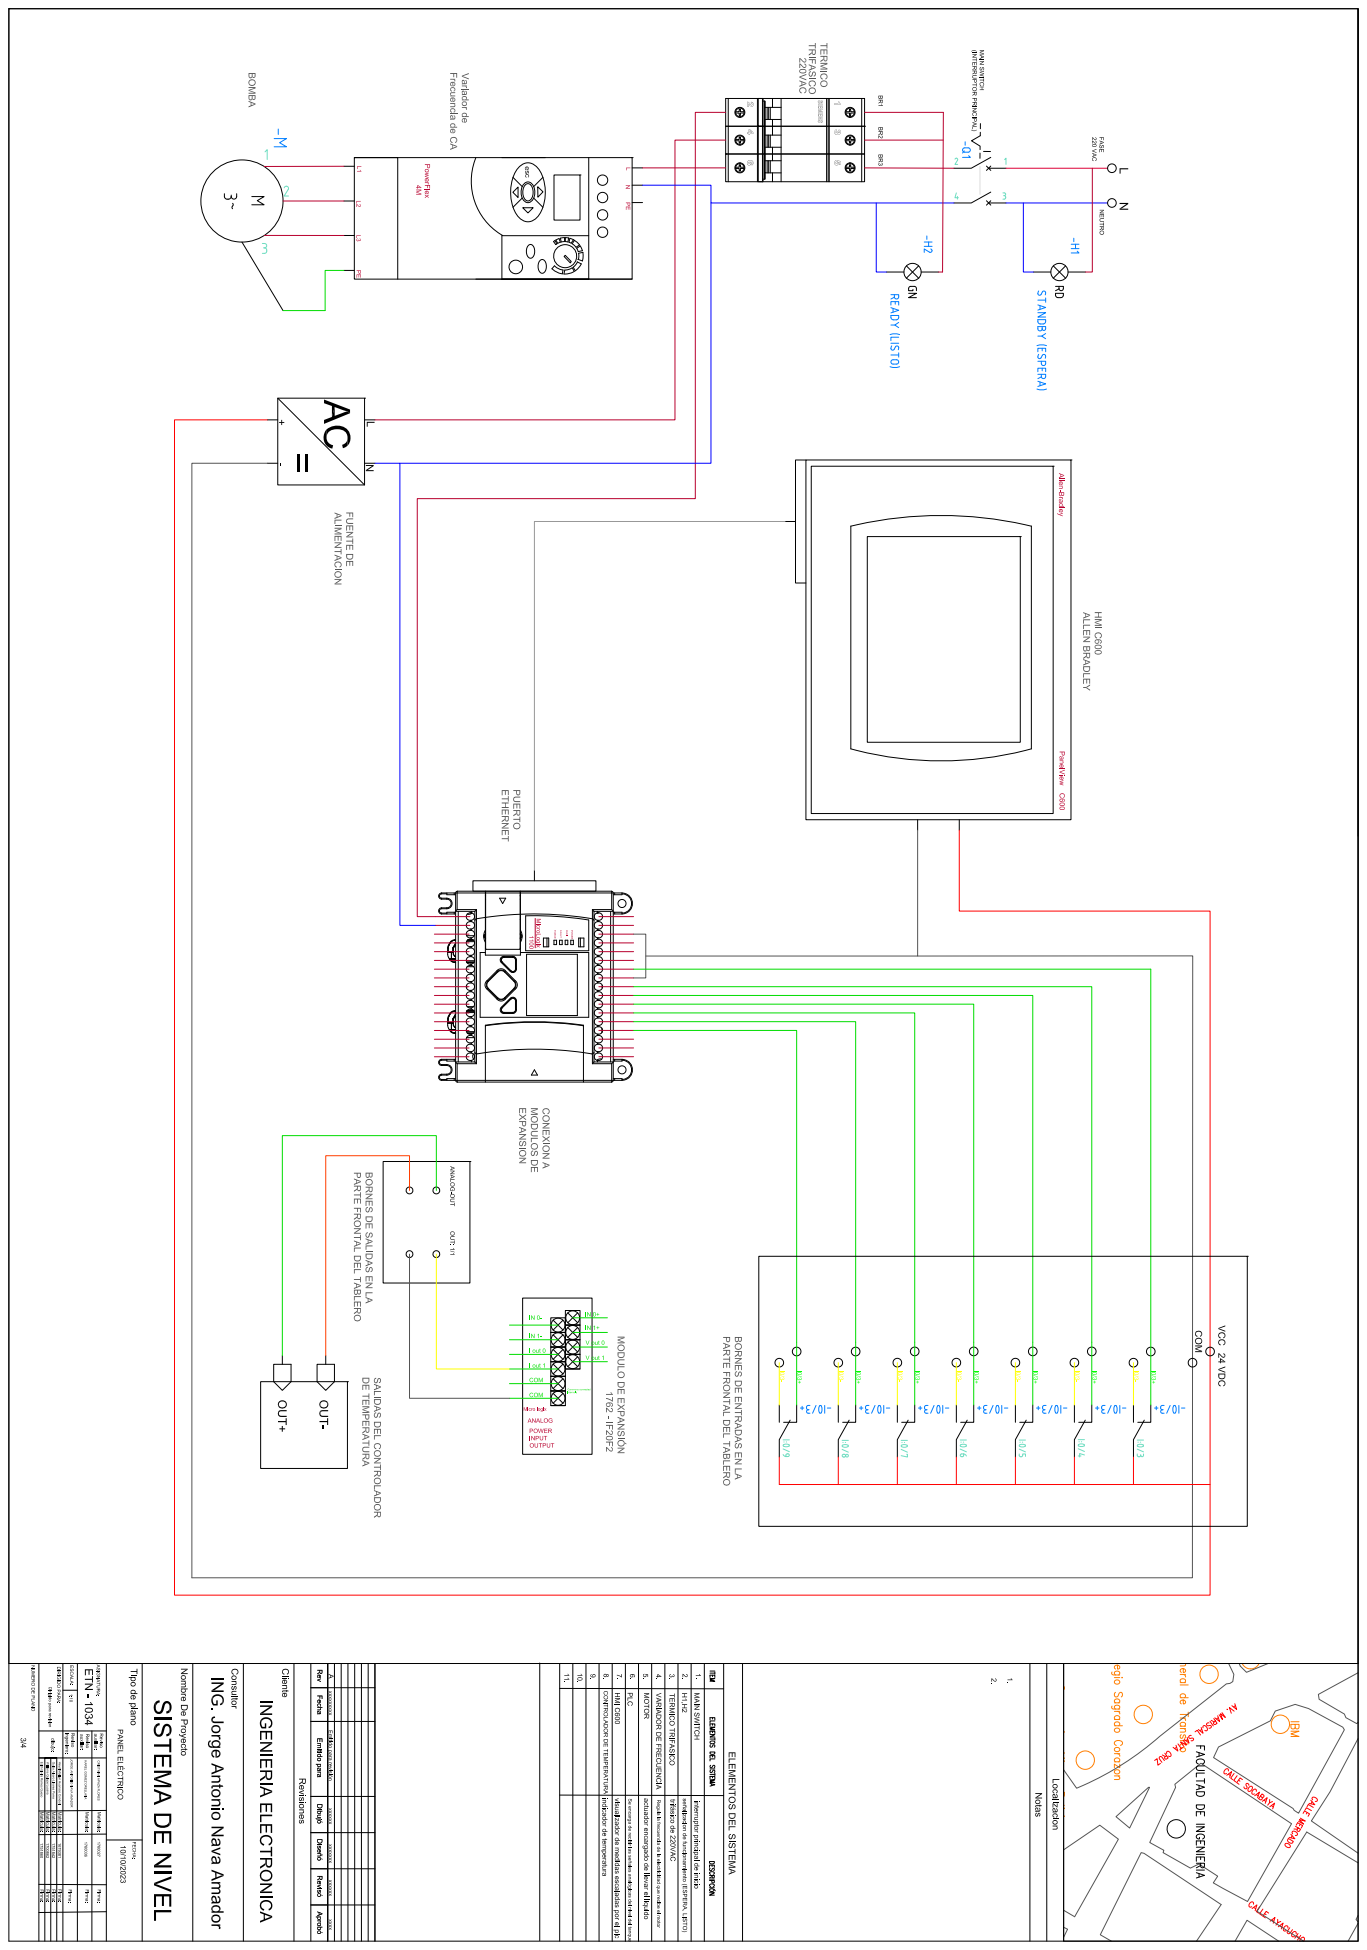
[picture p342: page 1]
