Jamkly/planta-nivel-umsa/semestres/II 2023/1. Representación/Diagramas/Documentos PDF/SISTEMA DE NIVEL - 4 DIAGRAMA ELECTRICO DEL PANEL 2.pdf

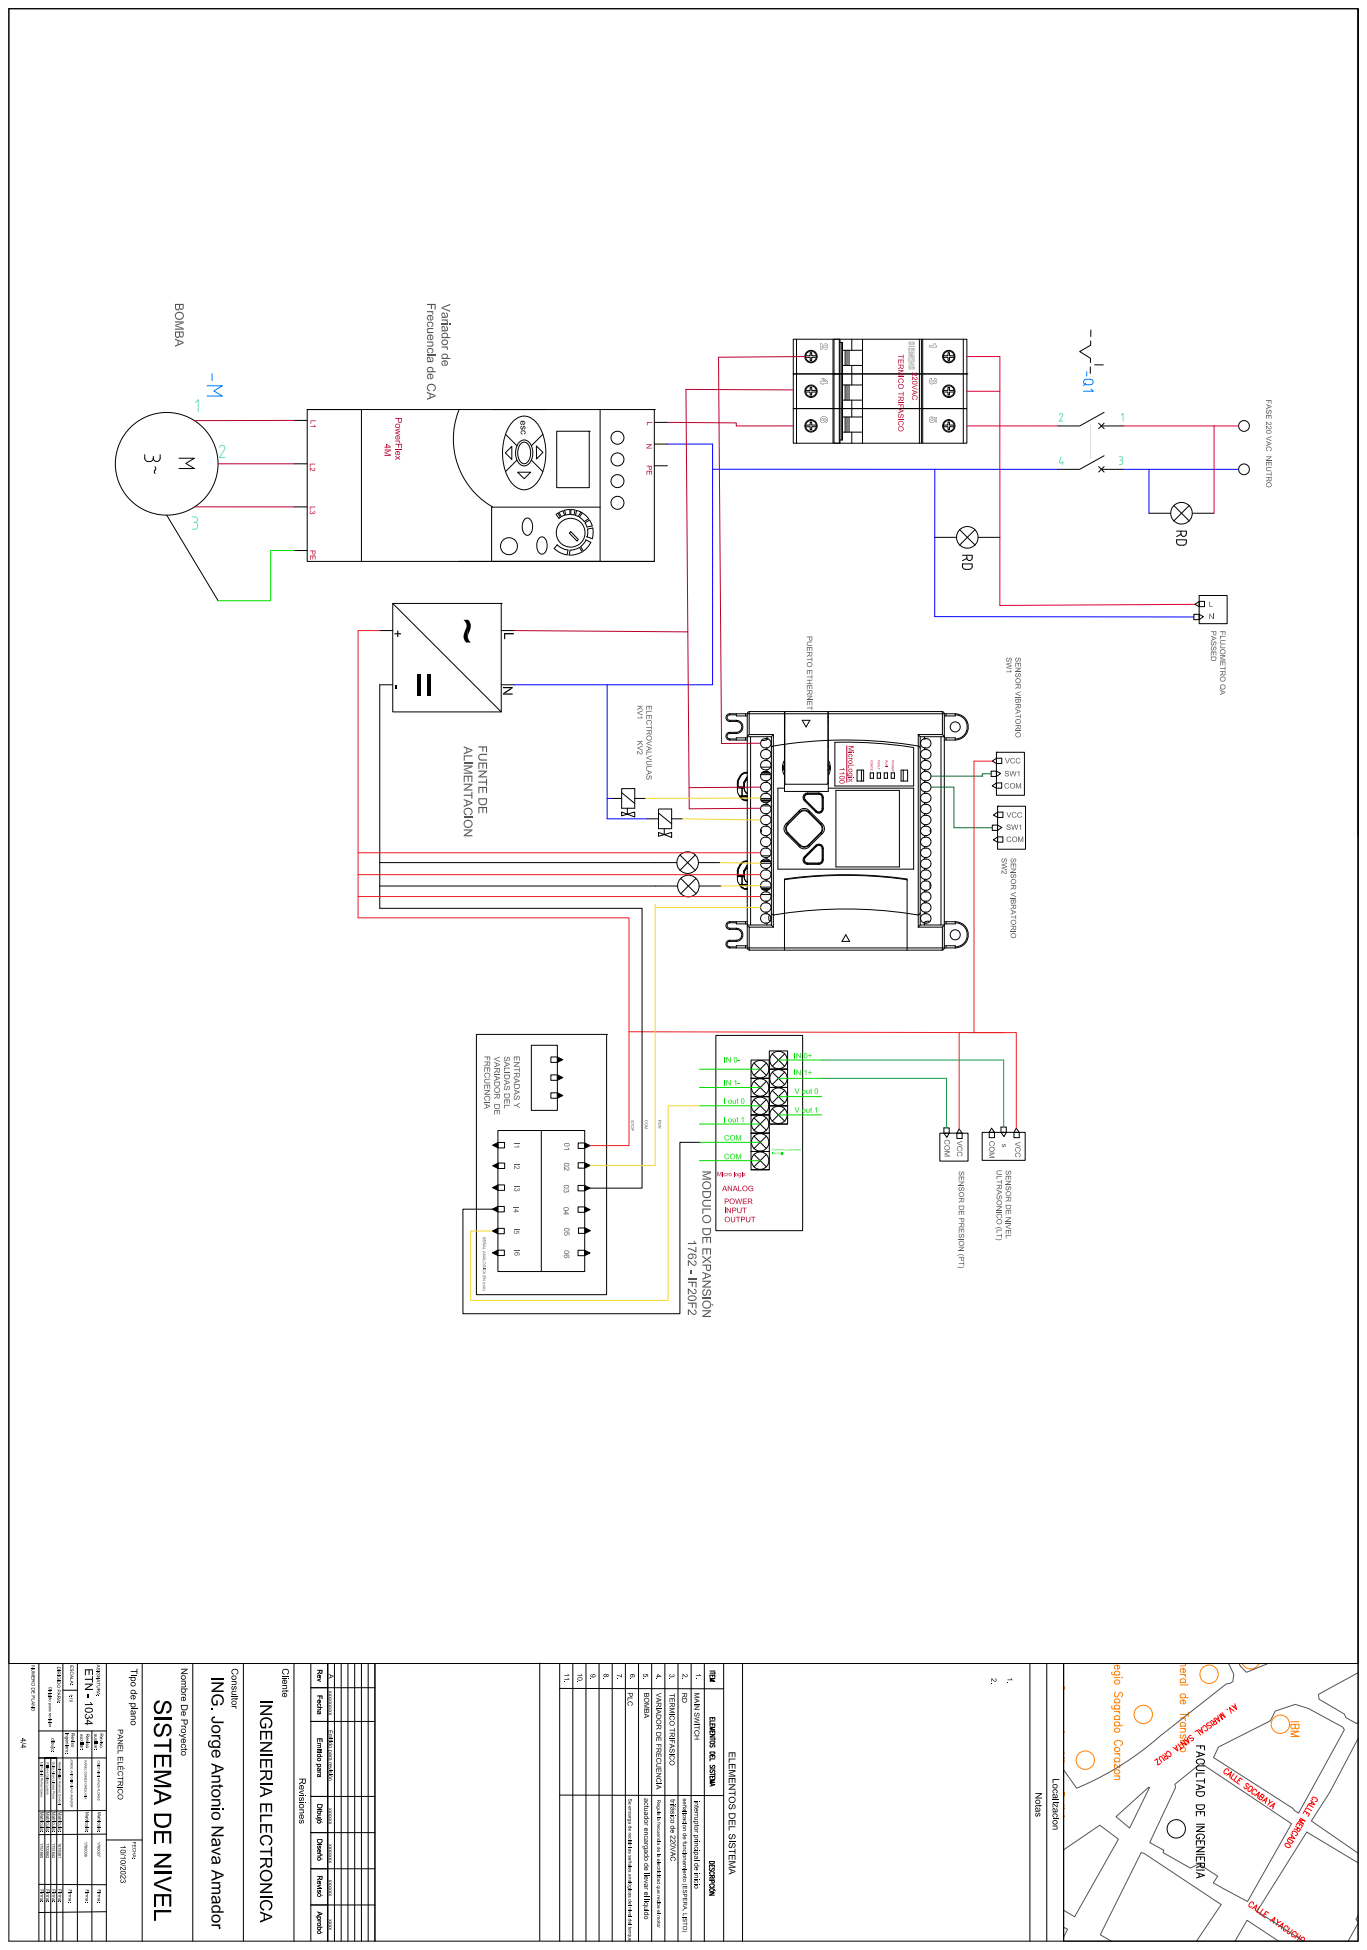
[picture p343: page 1]
