Jamkly/planta-nivel-umsa/(commit log)

2026-10-19 Agrega portal documental para Cloudflare
2026-10-20 PRUEBA CARPETA
    En esta ocasión estamos probando la sincronia entre subir y descargar las carpetas
2026-10-20 actualizacion pagina
    Agrega las estrellitas de acceso directo
